shaneharper/LG_webOS_brightness_and_volume_controller/(commit log)

2026-04-14 Knobs.jpg: Add labels.
    The labels were printed on sticker paper.
2026-04-17 Reduce/remove ADC output noise.
    I used to sometimes notice the volume jump back and forward between two levels.
    It's still possible to increase/decrease the brightness or volume by 1%.
    [HysteresisADC.h, read_knobs.ino]
2026-05-06 Resend brightness and volume to the TV after PC resumes from sleep and after HDR enabled/disabled state is changed.
    Also, the Windows app now discovers which COM port the Arduino is connected to. (Previously COM4 was hard-coded.)
2026-06-02 Discover the Arduino COM port by VID:PID via SetupAPI
    This stops the app from opening foreign serial devices (webcams,
    Bluetooth virtual ports, modems) while hunting for the knob controller.
    Also:
    - Tooltip gains a second line while disconnected: the port being tried, or
    the last connection error.
    - Set write timeouts on the COM port, not just read timeouts.
    - Rename enumerate_COM_ports -> enumerate_possibly_Arduino_COM_ports and
    COM_port_appears_to_be_arduino -> device_runs_brightness_and_volume_app.
    - Document the unresolved hang risk on the timeout-less COM open/config calls.
2026-06-03 Add AutoHANDLE::read().
    AutoHANDLE::read() returns a std::optional so a failed read (e.g. the Arduino unplugged) stays distinct from an empty read (call timed out with no data).
    Note: With the previous commit (and before) Visual Studio generated lnt-uninitialized-local messages in the Error List pane; that no longer happens for this version. (This version introduces an insignificant delay initially filling the buffer used by ReadFile() with 0s.)
